pbrook/cube3/hardware/cube3.kicad_pcb

## KiCad design hardware/cube3.kicad_pcb (2014-05-13)

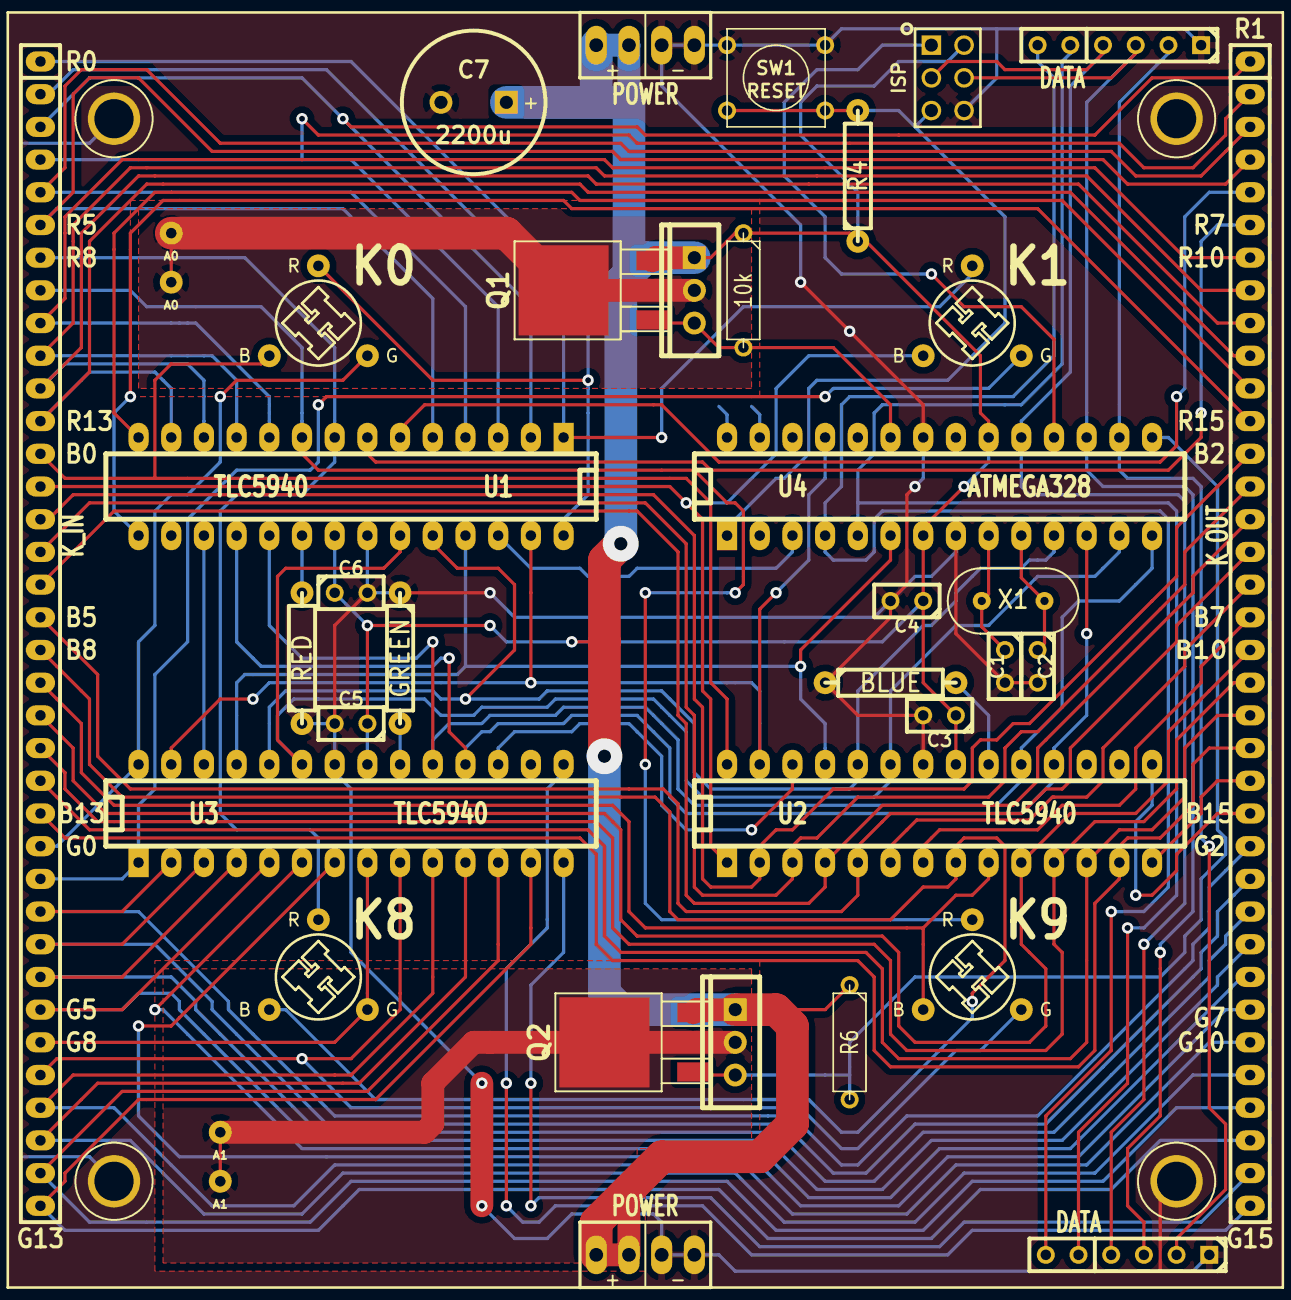
[picture p1: board cube3.kicad_pcb from above]

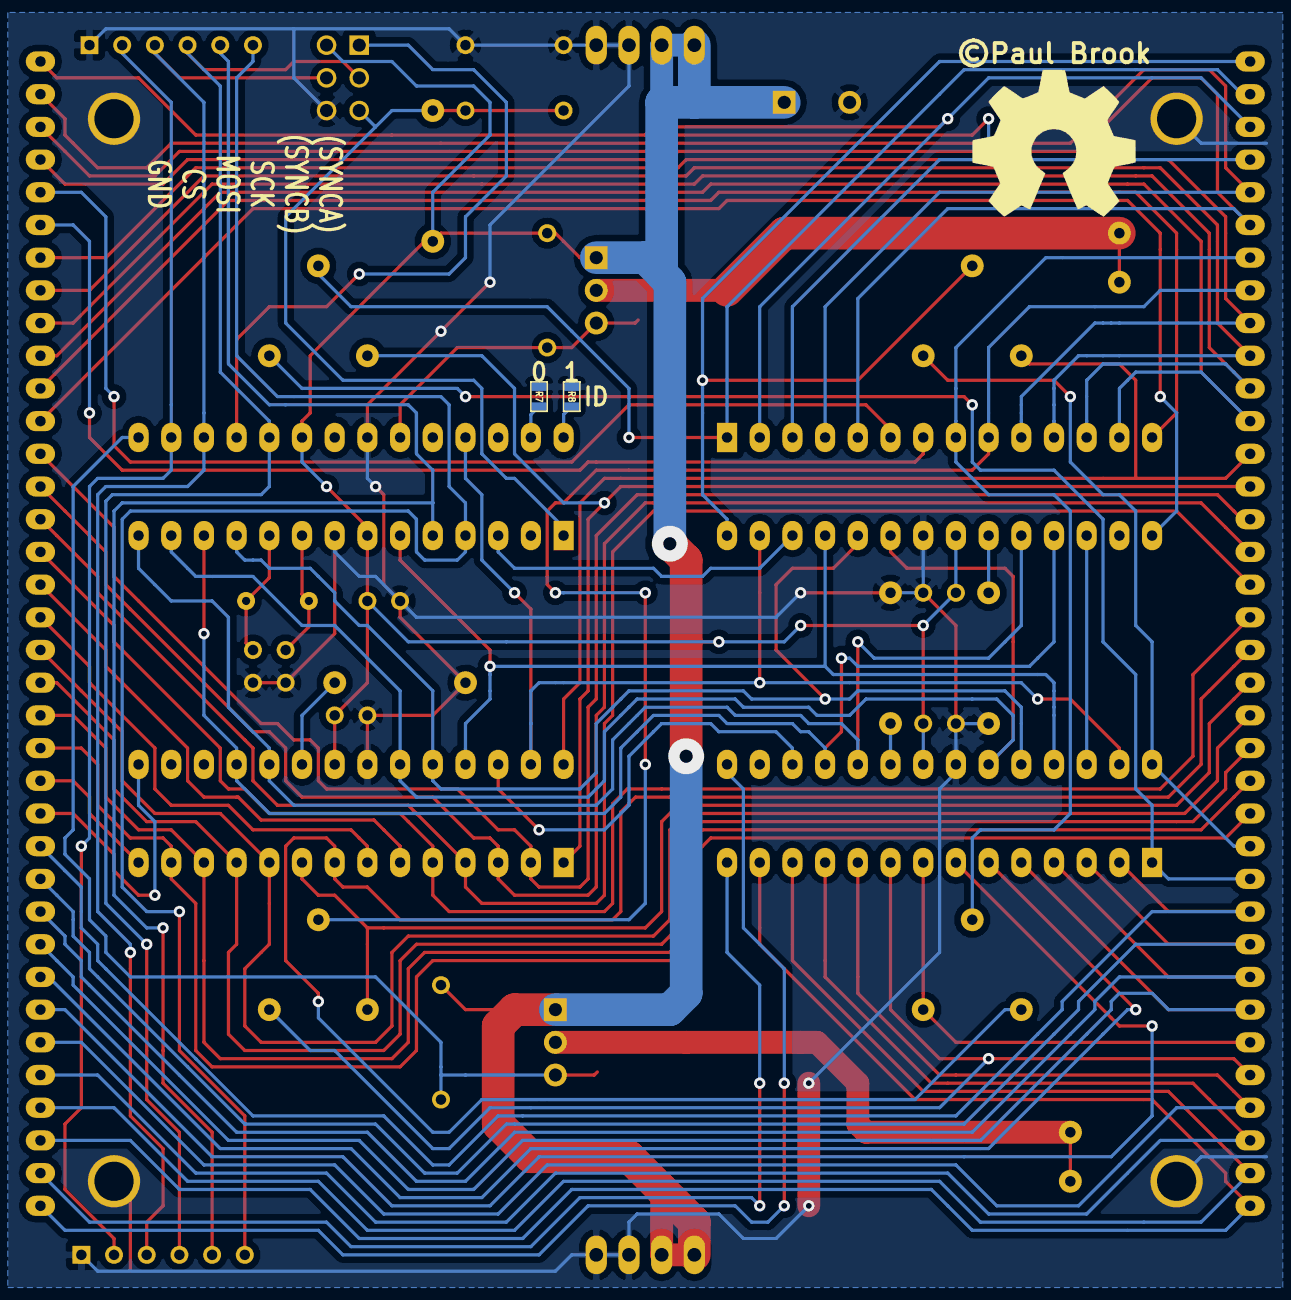
[picture p2: board cube3.kicad_pcb from below]

Board: 2 copper layers, 44 parts (2 on the bottom side), 77 nets.

Parts:
C1, C2: 22p; C1
C3, C4, C5, C6: 100n; C1
C7: 2200u; CP2V10
K0, K1, K8, K9: RGB_CATHODE; rgb_cathode
P1, P2: POWER; power2
P3, P4: DATA; SIL-6
P5: ISP; isp
P6, P7: A0; PIN1
P8, P15: A1; PIN1
P9: K_OUT; SIL-36
P10: K_IN; SIL-36
P11, P12, P13, P14: CONN_1; HOLE3
Q1, Q2: AP4435GH; to252
Q3, Q4: CONN_3; TO220_VERT
R1: RED; R4-LARGE_PADS
R2: BLUE; R4-LARGE_PADS
R3: GREEN; R4-LARGE_PADS
R4: 10k; R4-LARGE_PADS
R5, R6: 10k; R3-5
R7, R8: 0; SM0603
SW1: RESET; SW_PUSH_SMALL
U1, U2, U3: TLC5940; DIP-28__300_ELL
U4: ATMEGA328; DIP-28__300_ELL
X1: 16MHz; Crystal

Connections:
/5v: C3.1, C4.1, C5.1, C6.1, C7.1, P1.2, P2.2, P5.2, Q1.S, Q2.S, Q3.1, Q4.1, R4.1, R5.1, R6.1, U1.21, U2.21, U3.21, U4.7, U4.20
/A0: Q1.G, Q3.2, R5.2, U4.23
/A1: Q2.G, Q4.2, R6.2, U4.15
/BLANK: U1.23, U2.23, U3.23, U4.13
/BREF: R2.2, U2.20
/CS: P3.2, P4.2, U4.16
/DCPRG: U1.19, U2.19, U3.19, U4.14
/GND: C1.2, C2.2, C3.2, C4.2, C5.2, C6.2, C7.2, P1.1, P2.1, P3.1, P4.1, P5.6, P11.1, P12.1, P13.1, P14.1, R1.1, R2.1, R3.1, R7.1, R8.1, SW1.1, U1.22, U2.22, U3.22, U4.8, U4.22
/GREF: R3.2, U3.20
/GSCK: U1.18, U2.18, U3.18, U4.12
/H0: P6.1, P7.1, Q1.D, Q3.3
/H1: P8.1, P15.1, Q2.D, Q4.3
/ID0: R7.2, U4.27
/ID1: R8.2, U4.28
/MISO: P5.1, U4.18
/MOSI: P3.3, P4.3, P5.4, U4.17
/RESET: P5.5, R4.2, SW1.2, U4.1
/RREF: R1.2, U1.20
/SCK: P3.4, P4.4, P5.3, U4.19
/SCLK: U1.25, U2.25, U3.25, U4.6
/SIN: U1.26, U4.3
/SYNCA: P3.6, P4.6, U4.4
/SYNCB: P3.5, P4.5, U4.5
/VPRG: U1.27, U2.27, U3.27, U4.25
/XLAT: U1.24, U2.24, U3.24, U4.11
/b0: K0.B, P10.13, U2.28
/b1: K1.B, P10.14, U2.1
/b2: P9.13, P10.15, U2.2
/b3: P9.14, P10.16, U2.3
/b4: P9.15, P10.17, U2.4
/b5: P9.16, P10.18, U2.5
/b6: P9.17, U2.6
/b7: P9.18, U2.7
/b8: K8.B, P10.19, U2.8
/b9: K9.B, P10.20, U2.9
/b10: P9.19, P10.21, U2.10
/b11: P9.20, P10.22, U2.11
/b12: P9.21, P10.23, U2.12
/b13: P9.22, P10.24, U2.13
/b14: P9.23, U2.14
/b15: P9.24, U2.15
/g0: K0.G, P10.25, U3.28
/g1: K1.G, P10.26, U3.1
/g2: P9.25, P10.27, U3.2
/g3: P9.26, P10.28, U3.3
/g4: P9.27, P10.29, U3.4
/g5: P9.28, P10.30, U3.5
/g6: P9.29, U3.6
/g7: P9.30, U3.7
/g8: K8.G, P10.31, U3.8
/g9: K9.G, P10.32, U3.9
/g10: P9.31, P10.33, U3.10
/g11: P9.32, P10.34, U3.11
/g12: P9.33, P10.35, U3.12
/g13: P9.34, P10.36, U3.13
/g14: P9.35, U3.14
/g15: P9.36, U3.15
/r0: K0.R, P10.1, U1.28
/r1: K1.R, P10.2, U1.1
/r2: P9.1, P10.3, U1.2
/r3: P9.2, P10.4, U1.3
/r4: P9.3, P10.5, U1.4
/r5: P9.4, P10.6, U1.5
/r6: P9.5, U1.6
/r7: P9.6, U1.7
/r8: K8.R, P10.7, U1.8
/r9: K9.R, P10.8, U1.9
/r10: P9.7, P10.9, U1.10
/r11: P9.8, P10.10, U1.11
/r12: P9.9, P10.11, U1.12
/r13: P9.10, P10.12, U1.13
/r14: P9.11, U1.14
/r15: P9.12, U1.15
unnamed: C1.1, U4.9, X1.2
unnamed: C2.1, U4.10, X1.1
unnamed: U1.17, U3.26
unnamed: U2.26, U3.17
