pbrook/cube3/(threads)

Thread 1 (2018-02-26):

Add logic power bus

iMartyn, 2018-02-26:
Hi Paul,

I'm going slightly insane clearly because I am wanting to make another cube because I left my old one in the UK when I emigrated.

Given the power problems we saw with the LEDs draining the logic, I remembered the idea of adding a second 5v power bus for the logic of the chips.  I went ahead and forked the repo but then found that I quickly got out of my depth in kicad.  Mostly because kicad has moved on and doesn't recognise half the footprints but also because Global labels seem to be the way forward now, so I changed the GND and the (now two) power bus' to those, and now I can't get floods working.

Anyway, is there a chance you could add a 2nd power bus?  I can't buy you a Beer unless you are planning on being in Berlin any time soon but perhaps something else that can be ordered online easily?

Cheers,
--
Martyn
