pbrook/cube3/(commit log)

2014-05-12 Initial hardware design
    [cube3.kicad_pcb, cube3.sch]
2014-05-13 Final hardware tweaks.
    [cube3.kicad_pcb, cube3.sch]
2014-07-03 Reset serial link when unknown command encountered
    [main.c]
2014-07-07 Add multi-board sync.
2014-07-08 Avoid sending data when idle.
    [main.c]
2014-07-17 Fix race in sleep code.
    [main.c]
