pbrook/cube3/(notices)

Notices in the files:
hardware/cube3.kicad_pcb:
©Paul Brook
